10zin-lay/SeedsowingRobot/README.md

# SeedsowingRobot
Bluetooth controlled Seed Sowing Robot
